AndrankM/Close-Loop-Stepper-Control/docs/MIRO.PNG

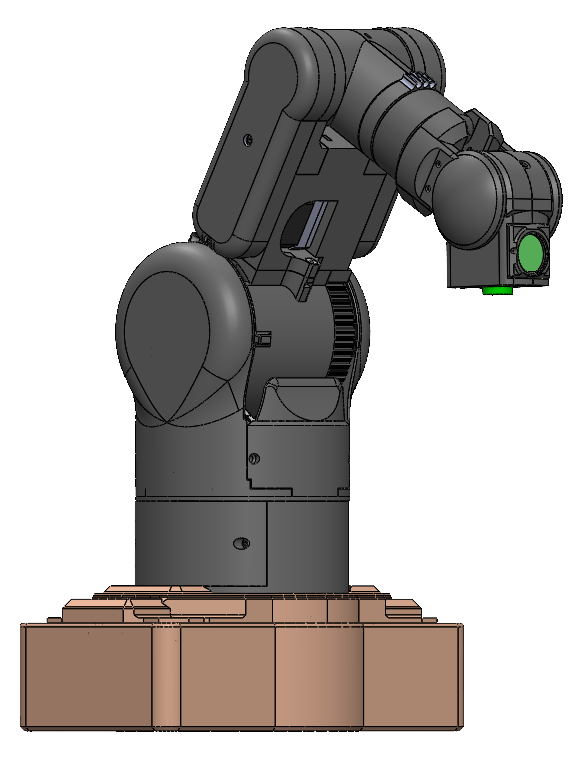
docs/MIRO.PNG
