AndrankM/Close-Loop-Stepper-Control/docs/miro_design_suggestions.png

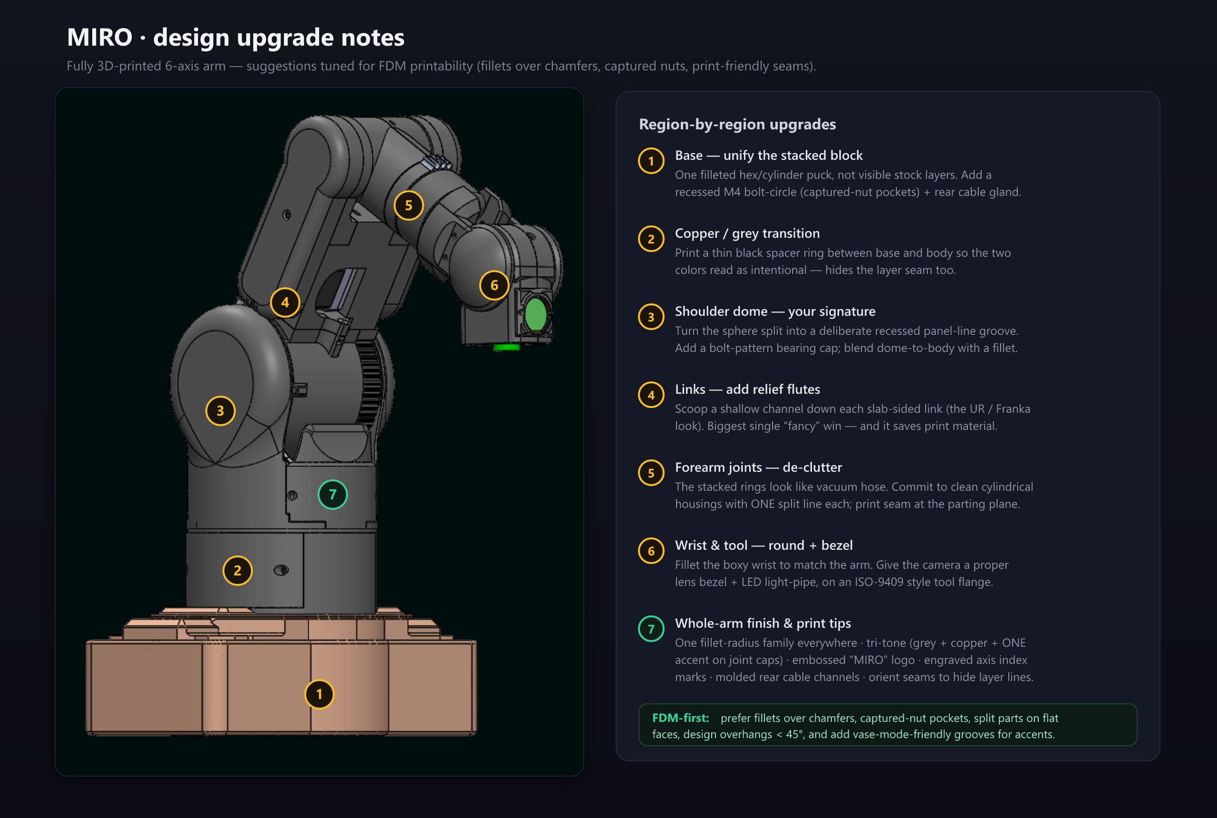
docs/miro_design_suggestions.png
