AndrankM/Close-Loop-Stepper-Control/docs/miro_encoder_playback.png

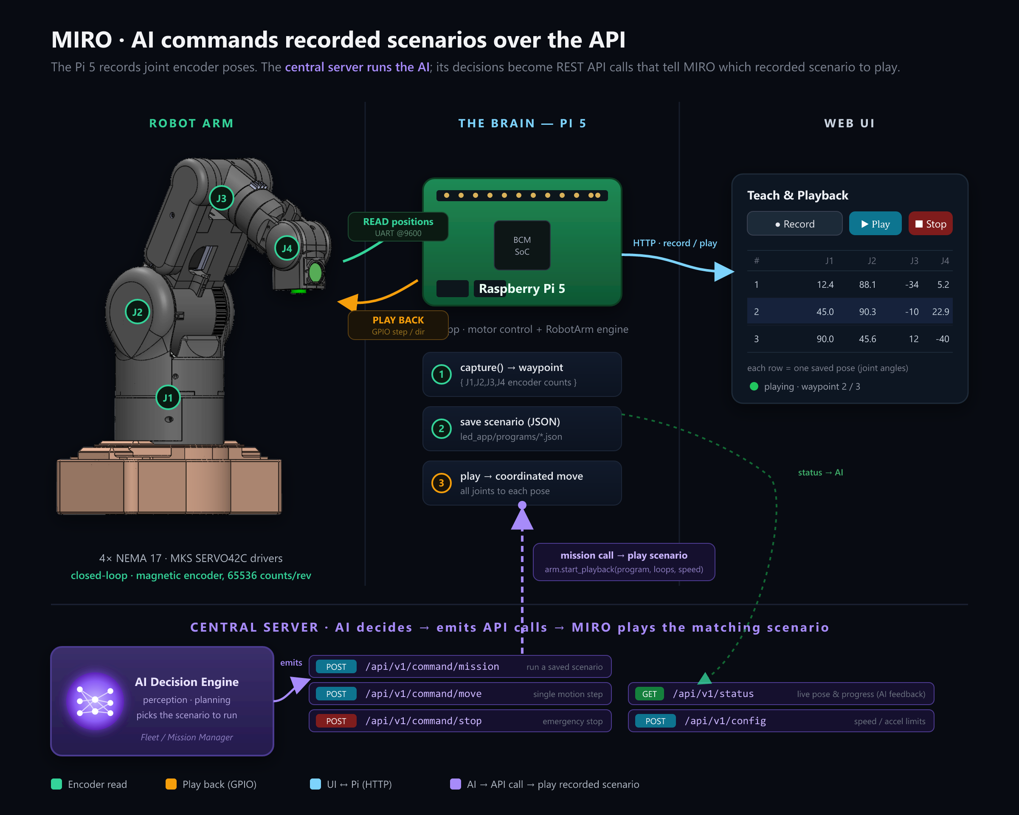
docs/miro_encoder_playback.png
