AndrankM/Close-Loop-Stepper-Control/docs/miro_redesign_concept.png

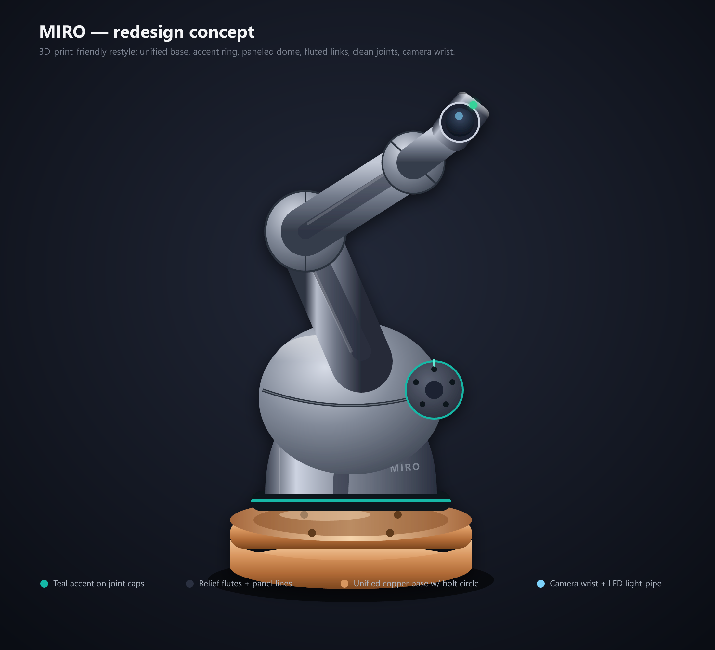
docs/miro_redesign_concept.png
