AndrankM/Close-Loop-Stepper-Control/led_app/static/robot/meshes/axis6.STL

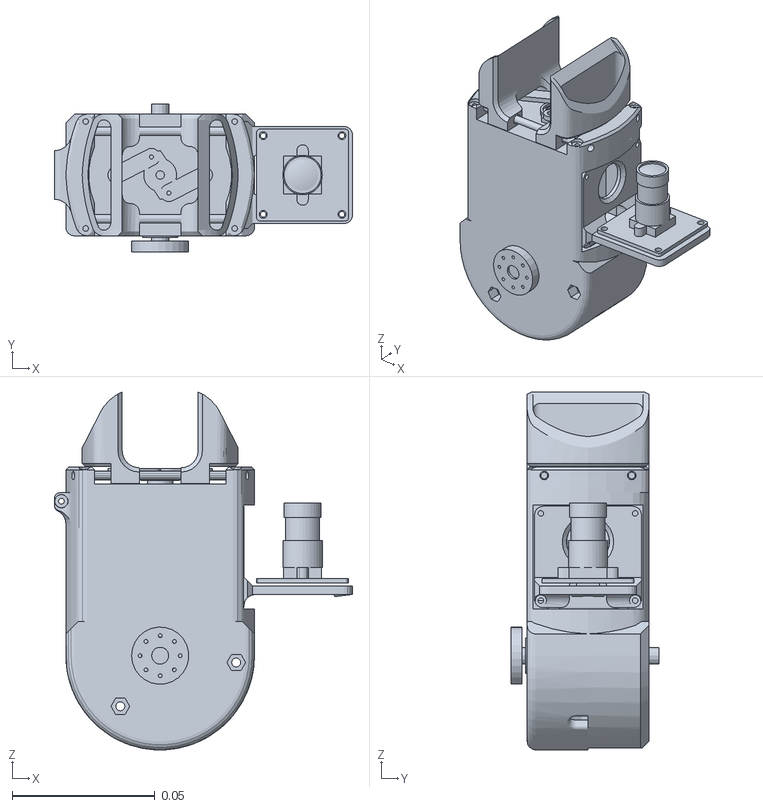
[picture p5: CAD file, 2026-06-21]
led_app/static/robot/meshes/axis6.STL
0.104 x 0.0519 x 0.125
