AndrankM/Close-Loop-Stepper-Control/led_app/static/robot/meshes/axis4.STL

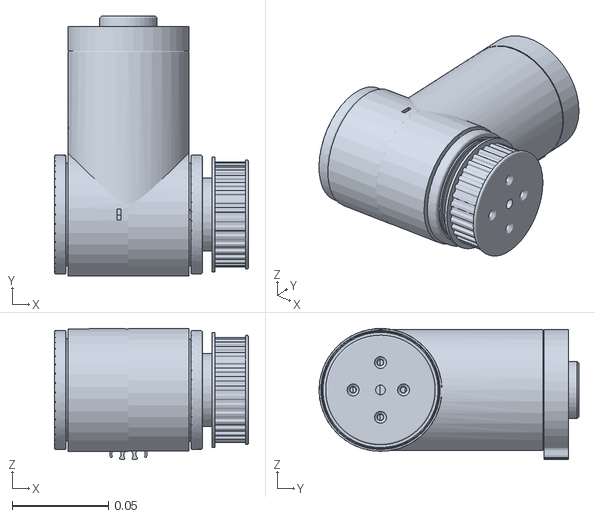
[picture p6: CAD file, 2026-06-21]
led_app/static/robot/meshes/axis4.STL
0.101 x 0.135 x 0.0682
