AndrankM/Close-Loop-Stepper-Control/led_app/static/robot/meshes/axis5.STL

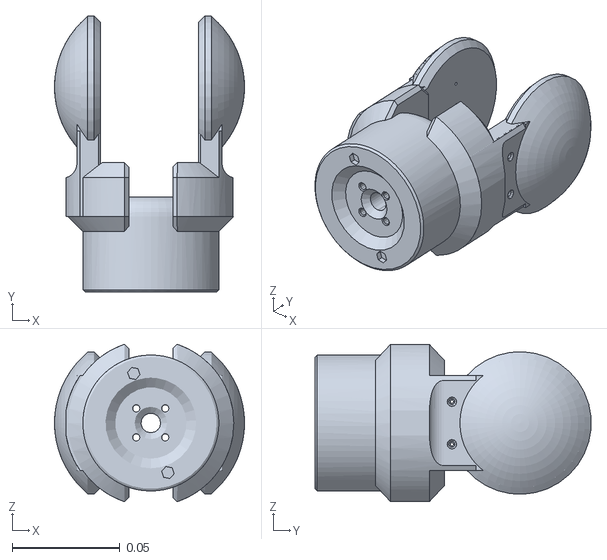
[picture p7: CAD file, 2026-06-21]
led_app/static/robot/meshes/axis5.STL
0.0881 x 0.128 x 0.0729
