AndrankM/Close-Loop-Stepper-Control/bitvise-upload-test.txt

put -o "d:\Git CLones\PI SSH Test\servo_test.sh" /tmp/servo_test.sh
