AndrankM/Close-Loop-Stepper-Control/(commit log)

2026-06-02 Initial commit: LED blink script and Flask web UI
2026-06-03 Add closed-loop stepper control with SERVO42C encoder feedback
    - Stepper enable/disable, direction, speed, RPM, acceleration ramp, soft/emergency stop
    - SERVO42C UART encoder reader (/motor/encoder) with angle, revolutions, turns counter
    - Live dashboard: angle dial, turns-since-reset counter, 30s time-series chart
    - Deploy script and diagnostic test scripts
    - README with hardware wiring and Pi 5 UART setup
    [app.py, motortest.py, motortest_noen.py]
2026-06-04 Add second geared motor, PWM stepping, and higher speed limit
    - Support two motors on a shared multi-drop UART bus (addr 0xE0/0xE1)
    - Parameterize motor/encoder routes as /motor/<mid>/...
    - Add 5:1 planetary gear ratio for motor 2 (output-shaft RPM/encoder)
    - Generate step pulses with hardware PWM for linear, accurate speed
    - Raise max speed from 2000 to 6000 sps
    - Add speedtest.py to measure actual motor speed via the encoder
2026-06-04 Update README for two motors, gearbox, PWM stepping, and shared UART
2026-06-06 Add motors 3 and 4 plus 4-driver UART bus schematic
    - Motor 3: EN GPIO10, STP GPIO9, DIR GPIO11, addr 0xE2 (direct drive)
    - Motor 4: EN GPIO0, STP GPIO5, DIR GPIO6, addr 0xE3 (direct drive)
    - Extend motors/encoders dicts and SERVO_ADDR3/4 env config
    - Add UI cards for motors 3 and 4
    - Add docs/uart_bus_4_drivers.svg multi-drop bus wiring diagram
2026-06-06 Update README for four motors (addresses 0xE0-0xE3, pins, env vars)
2026-06-07 Fix UI motor control: threaded Flask + non-blocking encoder polling
    - Run Flask with threaded=True so slow/dead encoder reads on the shared
    UART bus no longer block motor enable/disable/status requests (this caused
    all motors to appear STOPPED and unstartable from the web UI).
    - Shorten serial read deadline 0.5s->0.12s with fast-fail on partial frames;
    port timeout 0.2s->0.05s.
    - Make encoder polling self-scheduling (await then reschedule) and staggered
    per motor instead of a fixed 300ms setInterval, preventing request floods
    that exhausted the browser connection pool.
    - Move Motor 4 off GPIO0/5/6 to GPIO16/20/21 (GPIO0 is the ID_SD EEPROM pin).
    - Rework dashboard into a compact 2x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
    [app.py]
2026-06-07 Add teach/playback, hold-to-jog, and global emergency stop
    - RobotArm engine: capture encoder poses, coordinated closed-loop playback
    (per-joint P-control + auto-learned polarity), adjustable speed/dwell/loops,
    and named JSON programs persisted on the Pi (path-validated).
    - StepperMotor position-hold (pause/run_pulses) so joints can freeze in place;
    enable() now also resumes a held motor so the existing panel works on top of
    teach/playback instead of leaving it silently paused.
    - Per-motor momentary hold-to-jog buttons (CW/CCW) using pointer capture.
    - Global emergency stop: POST /estop hard-stops all motors + playback, with a
    header button and a sticky floating button; per-motor E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
2026-06-09 Add emotion detection UI mockup and MIRO architecture diagram
    - New /emotion page (templates/emotion.html) + /emotion/latest JSON stub (falls back to simulated data until camera is wired)
    - Link to emotion page from main control UI
    - docs: MIRO encoder-playback architecture diagram (SVG+PNG) using real MIRO render with J1-J4 badges
    - docs: animated emotion-detection UI mockup (HTML+GIF) and teach/playback panel SVG
2026-06-13 Jog-only motor control: Enable now holds position without moving
    - Remove per-motor Direction control (Jog mode replaces it)
    - enable() energizes and HOLDS (no motion); motor only moves via jog/playback
    - Add /motor/<id>/jog route (on=move while held, off=hold position)
    - Jog buttons use the new route
    [app.py]
2026-06-13 Show Pi 5 SoC temperature in the UI header
    - Add /system/temp route reading /sys/class/thermal/thermal_zone0/temp
    - Header temperature chip, polled every 4s, with warm/hot color thresholds
2026-06-13 Add Pi 5 health card (CPU, memory, disk, uptime, power/throttling)
    - New /system/health endpoint: CPU usage+load, temp, freq, memory, disk, uptime, core voltage, and vcgencmd throttling/undervoltage flags
    - Collapsible health card toggled from the header temp chip, polled every 3s
    - Highlights active undervoltage/throttling in red
2026-06-13 Add network, swap, and fan to Pi 5 health card
    Health endpoint now reports primary IP + live RX/TX throughput, swap usage, and active-cooler fan RPM; UI gains matching tiles
    [app.py]
2026-06-13 Add Pi 5 power draw (V/A/W) to health card
    Sum per-rail volts*amps from vcgencmd pmic_read_adc for total board power; derive input current from the 5V supply rail; new Power draw tile
2026-06-13 Smooth trapezoidal decel on jog-release/hold
    Motor worker now ramps current_speed down to zero at the configured accel rate when paused/soft-stopped instead of hard-zeroing it, giving a symmetric trapezoidal velocity profile (smooth accel and decel)
2026-06-13 Add Motor 3 end-stop limit switches (CW GPIO19 / CCW GPIO26)
    Pull-down 3.3V switches: pressed=HIGH. Motor stops immediately when the end-stop for its current travel direction is pressed; opposite direction still allowed to back off. UI shows live CW/CCW limit indicators and an END STOP state on the Motor 3 card.
2026-06-13 Update README: jog-only motion, trapezoidal accel/decel, Motor 3 end stops, Pi 5 health, emotion page
2026-06-14 Motor 3 end stop: single shared GPIO 26 line, direction inferred from travel
    Both limit switches share one input; the motor's current direction identifies which end was hit. Worker latches/clears the blocked direction; UI shows one end-stop pill and END STOP(dir) state.
2026-06-14 Add Motor 4 end-stop limit switch on shared GPIO 19
    Reuses the same single-line end-stop logic as Motor 3 (direction inferred from travel).
2026-06-15 Motor 1 now 5:1 geared (swapped NEMA 17 with planetary reducer)
    [app.py]
2026-06-20 Add on-device camera + emotion detection (USB U20CAM, YuNet + FER+, MJPEG stream, UI camera card)
2026-06-20 Throttle vision CPU: YOLO 3fps+224px, camera 10fps when objects on, service Nice=10 CPUQuota=70%
2026-06-20 Add emotion detection ON/OFF toggle button in camera card UI
2026-06-20 Switch WS2812 emotion rings to shared GPIO18 data line
2026-06-20 LED rings: drive WS2812 via SPI MOSI (GPIO10) for Pi 5 RP1 compatibility
2026-06-20 Move Motor 3 off GPIO 9/10/11 (SPI0) so WS2812 rings can use SPI MOSI on Pi 5
2026-06-20 Add 'Test LED rings' button + /emotion/rings/test route (R/G/B/white/chase sweep)
2026-06-20 Add servo motor support for axes 5 & 6 (GPIO 12/13, hardware PWM); UI sliders + REST routes
2026-06-20 Fix servo UI: correct backtick escaping in template literals
2026-06-20 Stabilize 270deg servos: AngularServo calibration + throttled slider commands
    [app.py]
2026-06-20 Add servo Power ON/OFF + Hold ON/OFF controls (backend routes + UI buttons)
2026-06-20 Add per-servo idle detach delay control (UI slider + backend route)
2026-06-21 Add 3D digital twin: Pose & Send control (3D model drives real arm)
    - Twin joint->actuator remap for base-fixed URDF (joint1-3 steppers, joint4 tilt, joint5 gripper)
    - Backend Pose & Send executor: angle->encoder-counts, closed-loop move, smooth servos; pauses encoder poller during move
    - Safety: requires Set home (is_zeroed), rejects during playback/free-drive, per-joint limit clamps, STOP
    - Routes: /twin/config, /twin/limits, /twin/move, /twin/move_status, /twin/stop
    - UI: Mirror/Command modes, per-joint sliders, speed, Arm safety, limits editor; standalone twin_ui_preview.html
    - Rollback point: previous good version is commit e8f8a4f
    [axis4.STL, axis5.STL, axis6.STL, robot.urdf]
2026-06-22 Add Motor 2 hall limit GPIO mapping, LED UI controls, and README GPIO/API updates
2026-06-23 Problem with the Motor two, it is getting limit swich alwas ON even when it is not pressed. I have checked the wiring and it seems fine. I will try to replace the limit switch and see if that resolve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
    [app.py]
